hariksk25/Desk-assistant-/case_v6/renders/check_views.png

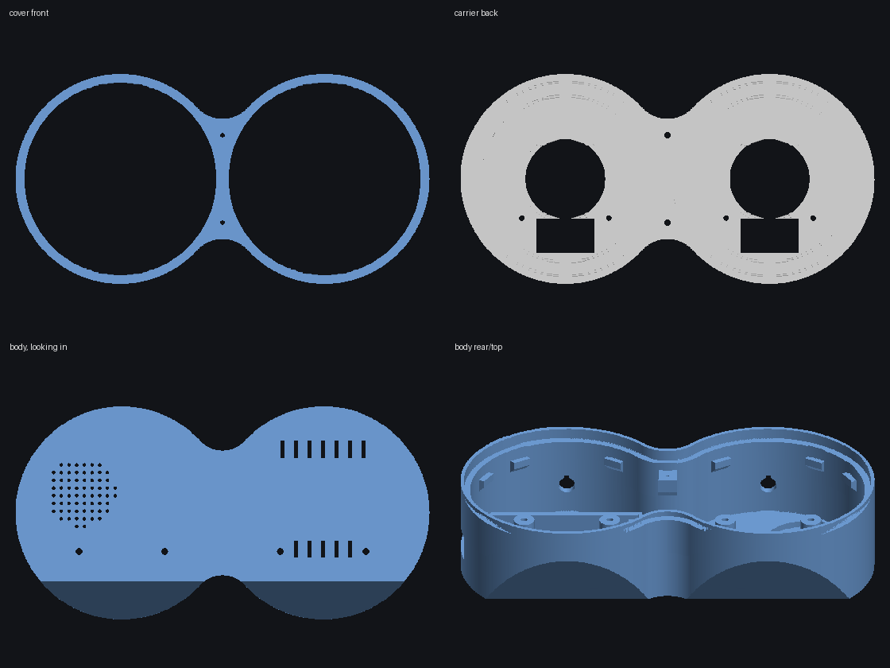
case_v6/renders/check_views.png
