hariksk25/Desk-assistant-/case_v6/renders/clamp_plates.png

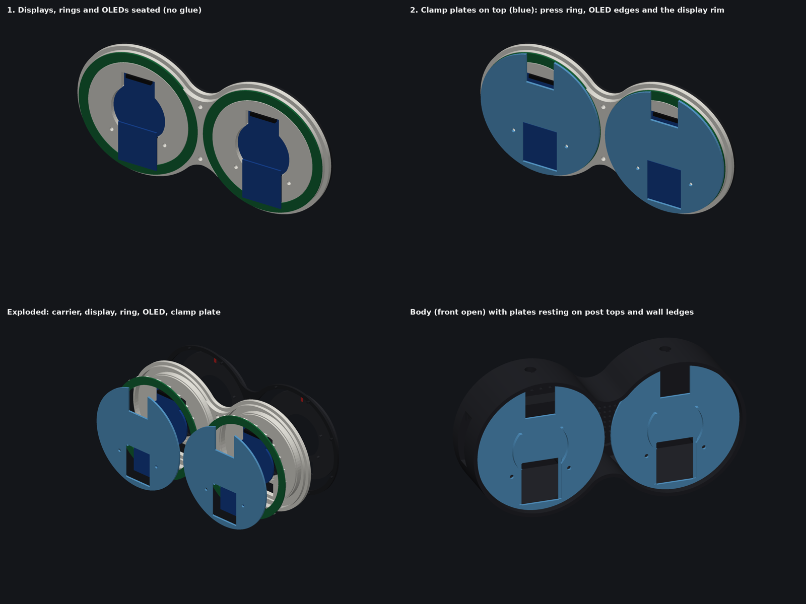
case_v6/renders/clamp_plates.png
