hariksk25/Desk-assistant-/case_v6/renders/final_back_seated.png

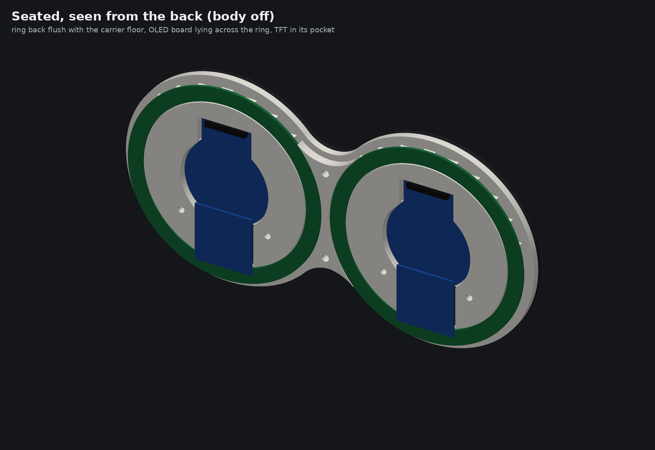
case_v6/renders/final_back_seated.png
