hariksk25/Desk-assistant-/case_v6/renders/final_body.png

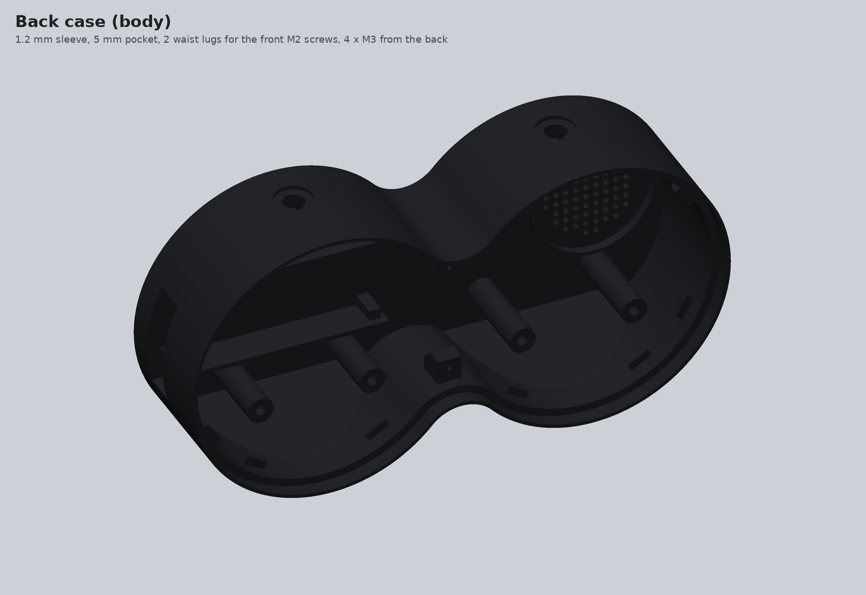
case_v6/renders/final_body.png
