hariksk25/Desk-assistant-/case_v6/renders/final_exploded.png

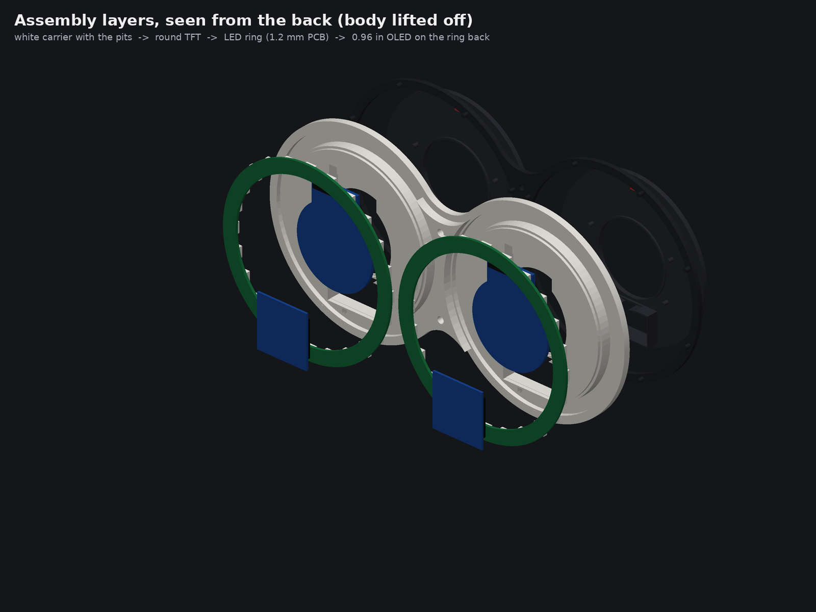
case_v6/renders/final_exploded.png
