hariksk25/Desk-assistant-/case_v6/renders/final_front.png

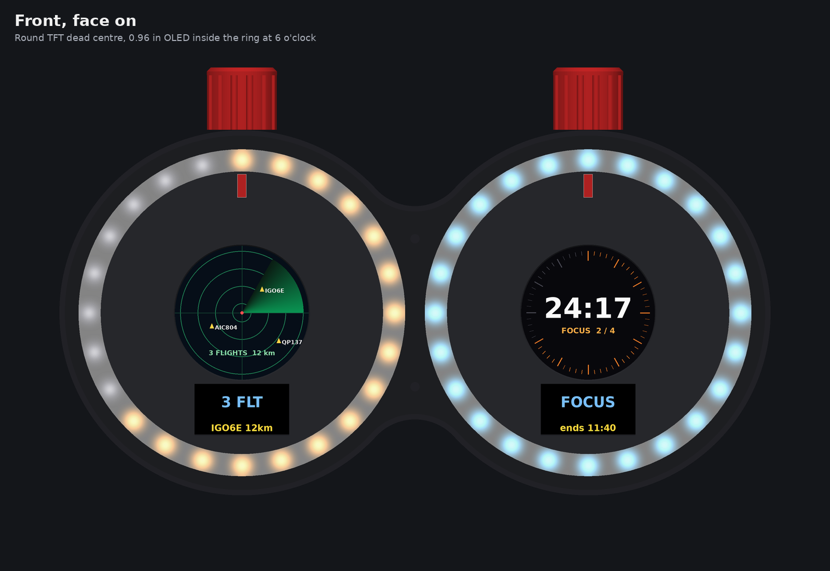
case_v6/renders/final_front.png
