hariksk25/Desk-assistant-/case_v6/renders/final_hero.png

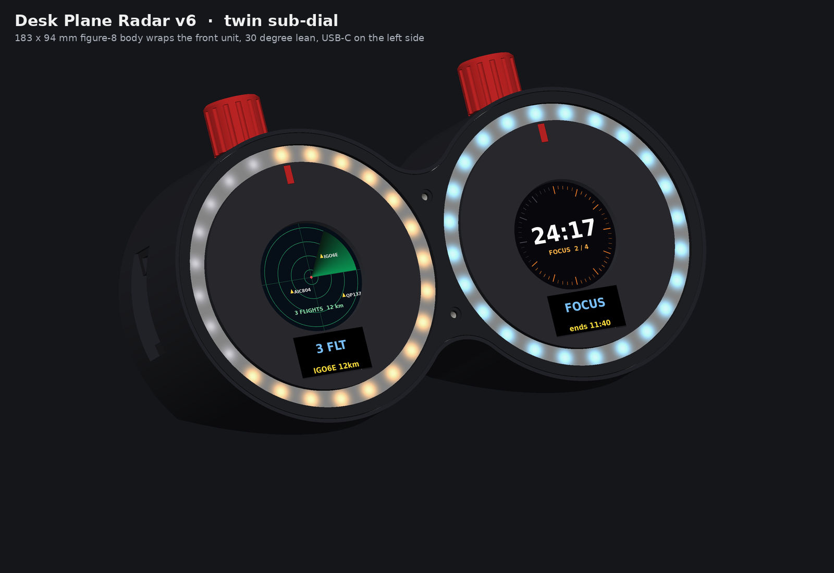
case_v6/renders/final_hero.png
