hariksk25/Desk-assistant-/case_v6/renders/final_rear.png

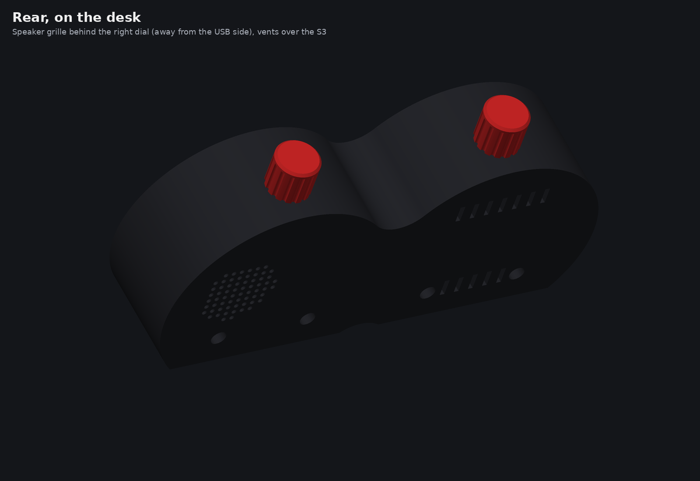
case_v6/renders/final_rear.png
