hariksk25/Desk-assistant-/case_v6/renders/final_side.png

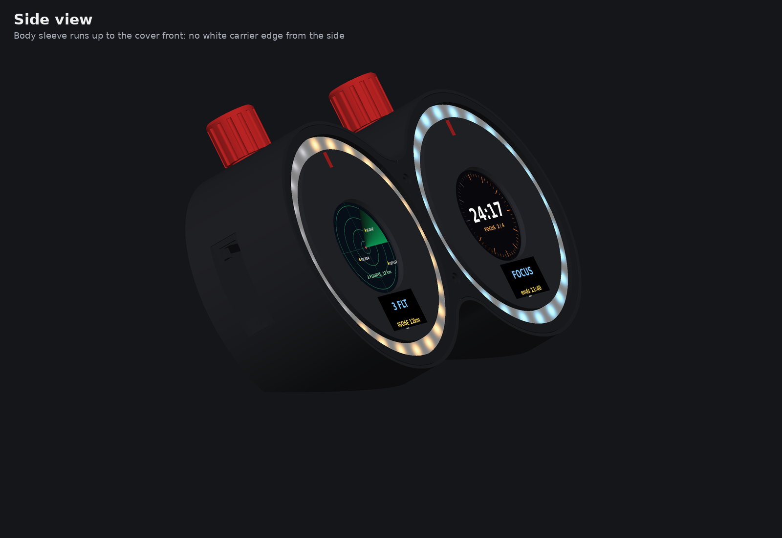
case_v6/renders/final_side.png
