hariksk25/Desk-assistant-/case_v6/renders/front_layouts_A_vs_horns.png

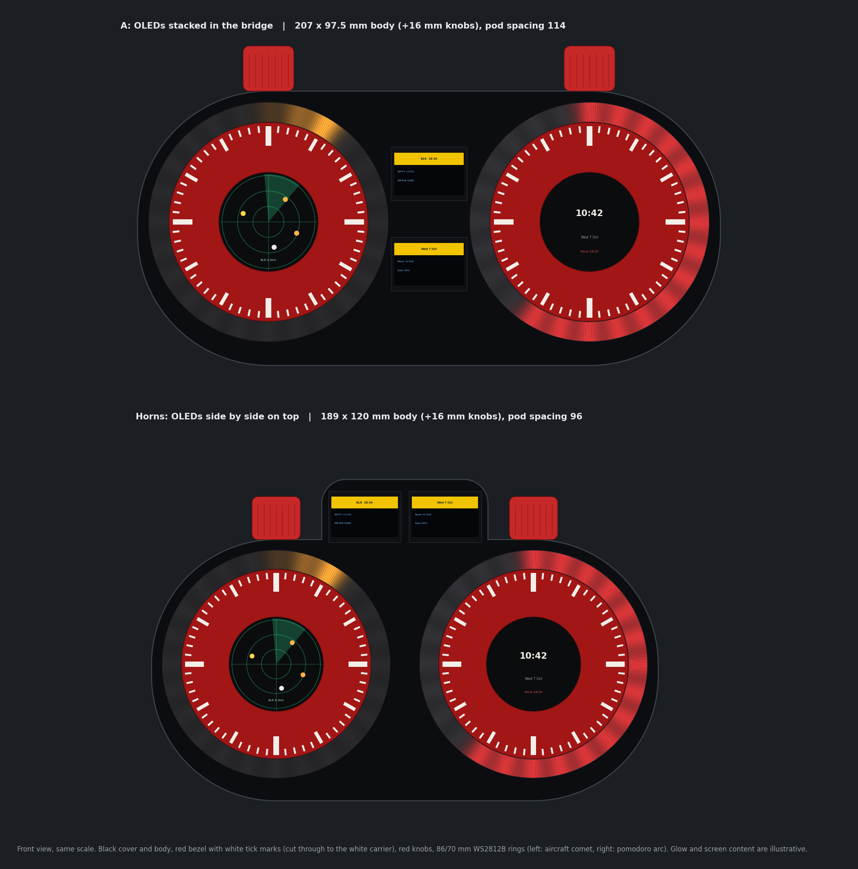
case_v6/renders/front_layouts_A_vs_horns.png
