hariksk25/Desk-assistant-/case_v6/renders/front_screw_section.png

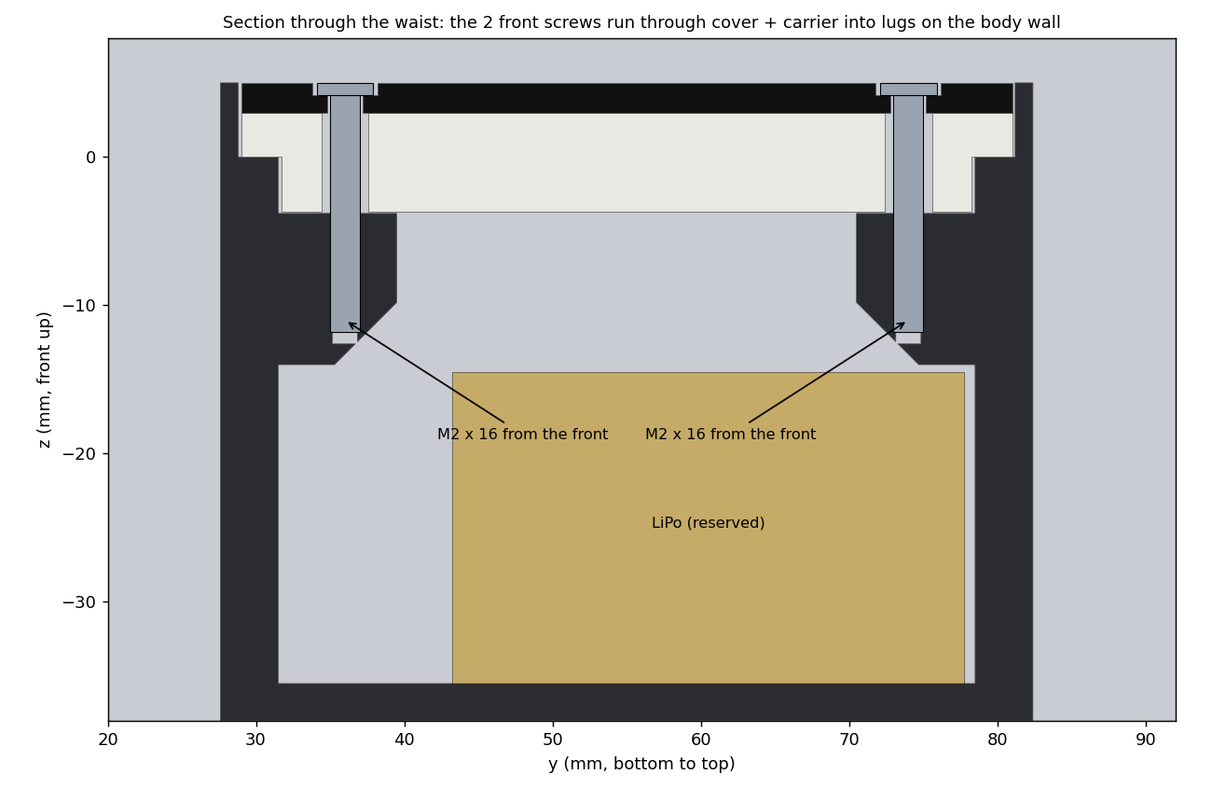
case_v6/renders/front_screw_section.png
