hariksk25/Desk-assistant-/case_v6/renders/internal_layout.png

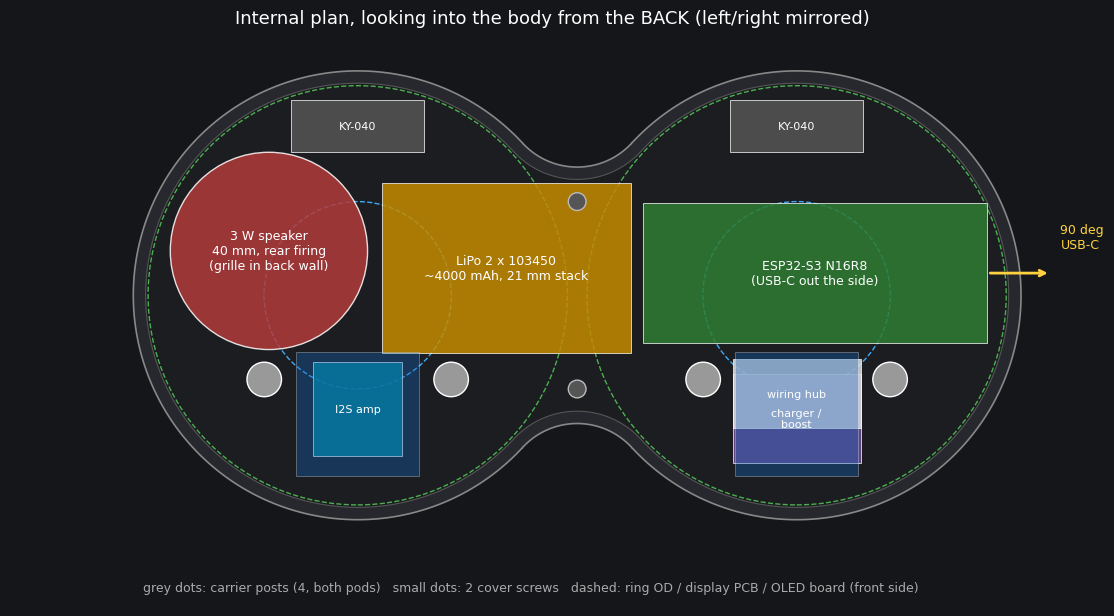
case_v6/renders/internal_layout.png
