hariksk25/Desk-assistant-/case_v6/renders/layout_variations.png

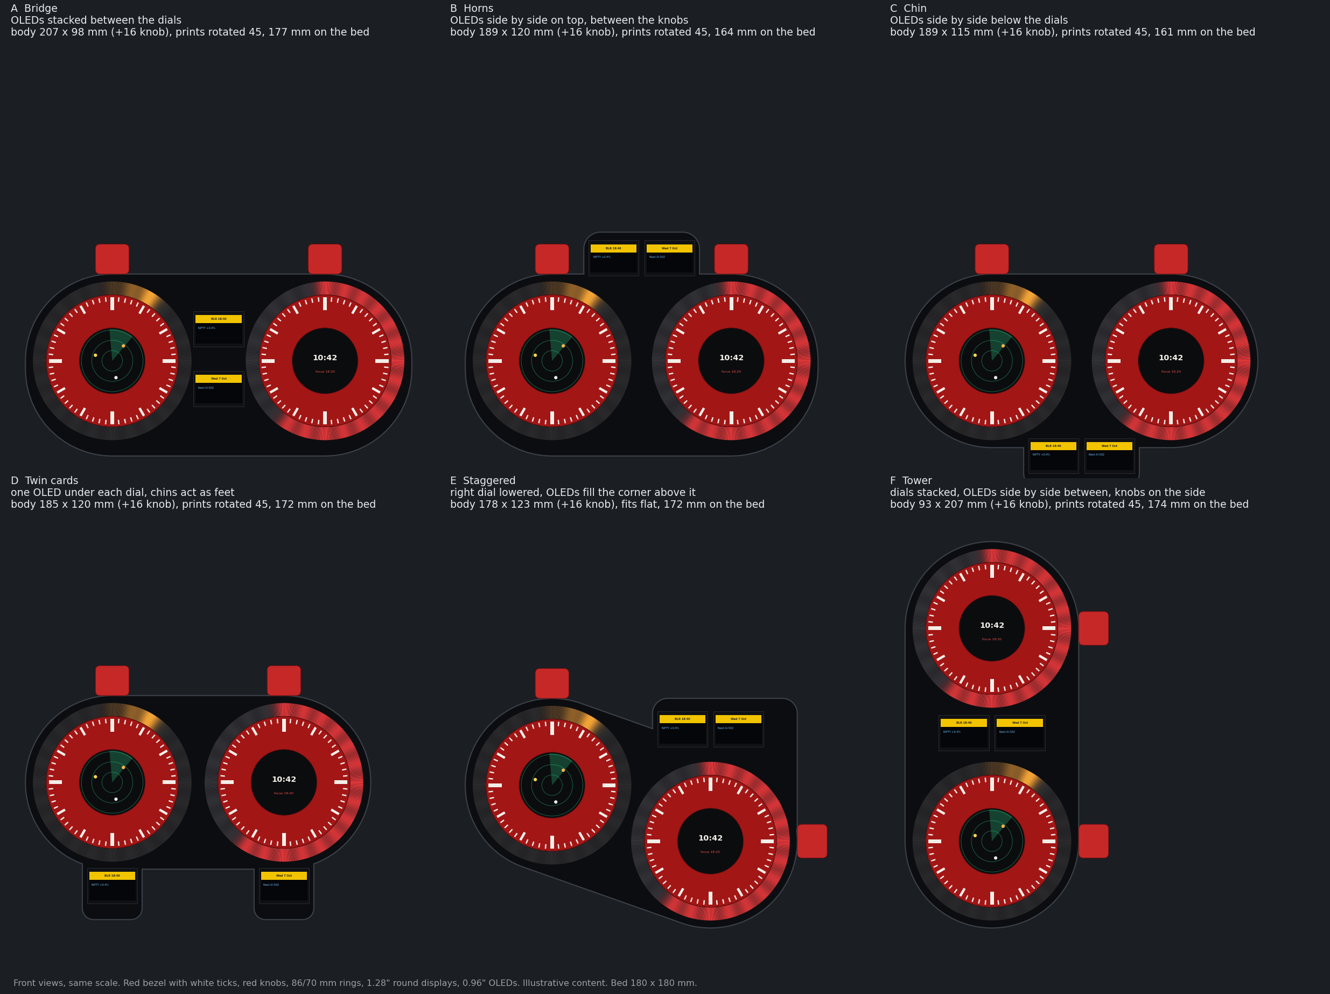
case_v6/renders/layout_variations.png
