hariksk25/Desk-assistant-/case_v6/renders/skirts.png

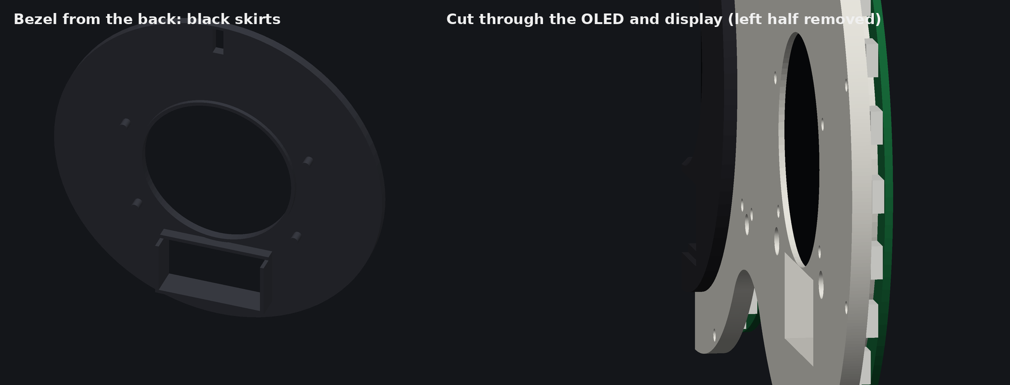
case_v6/renders/skirts.png
