hariksk25/Desk-assistant-/case_v6/renders/subdial_layout.png

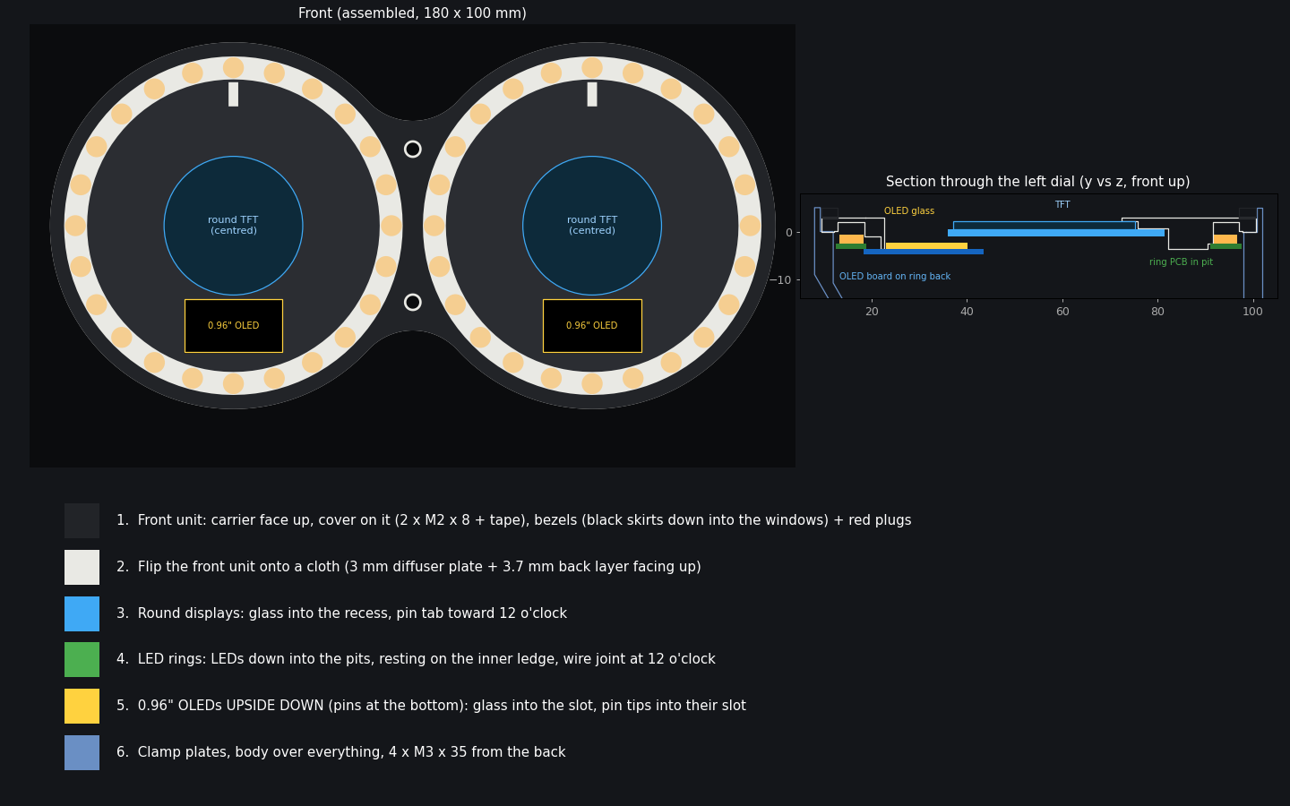
case_v6/renders/subdial_layout.png
