hariksk25/Desk-assistant-/case_v6/renders/v6_horns30_renders.png

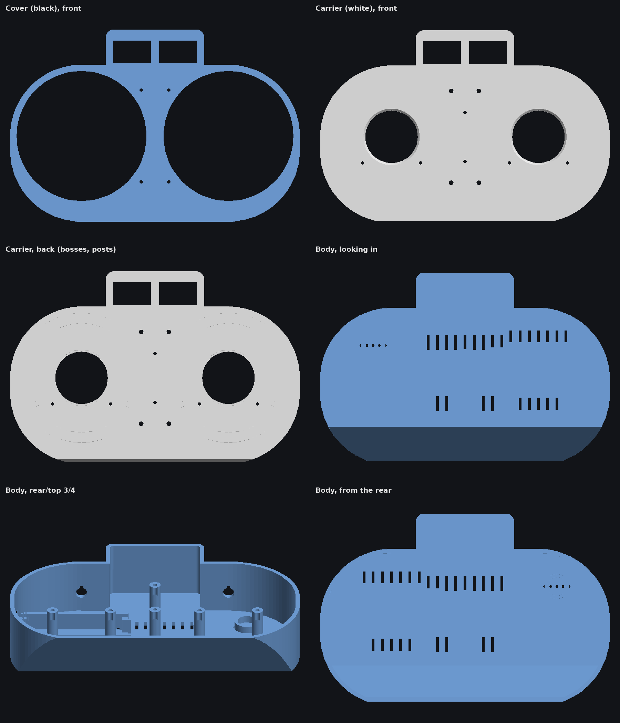
case_v6/renders/v6_horns30_renders.png
