hariksk25/Desk-assistant-/docs/datasheets/OLED_0.96in_yellow_blue_outline.png

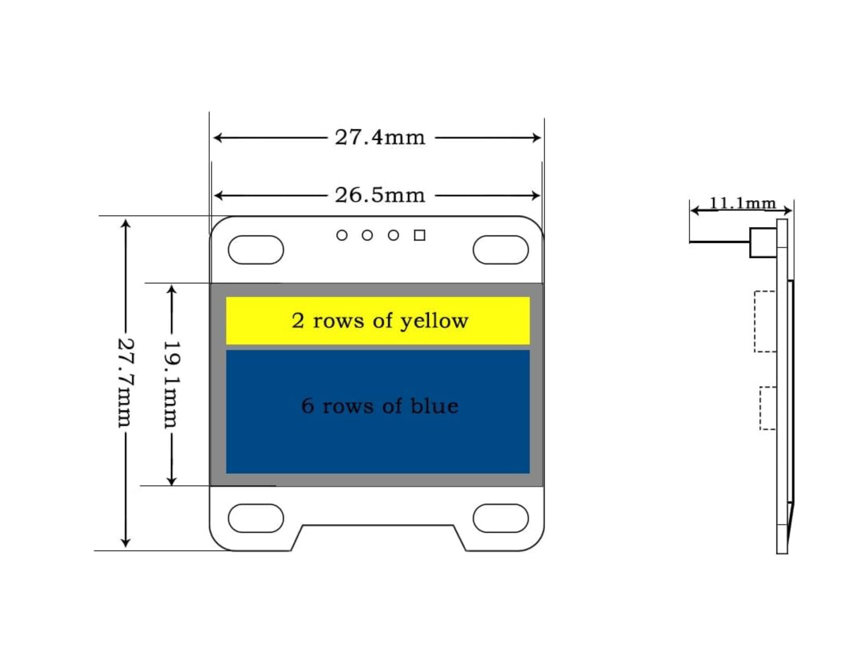
docs/datasheets/OLED_0.96in_yellow_blue_outline.png
