hariksk25/Desk-assistant-/docs/images/pinmap_s3_v6.png

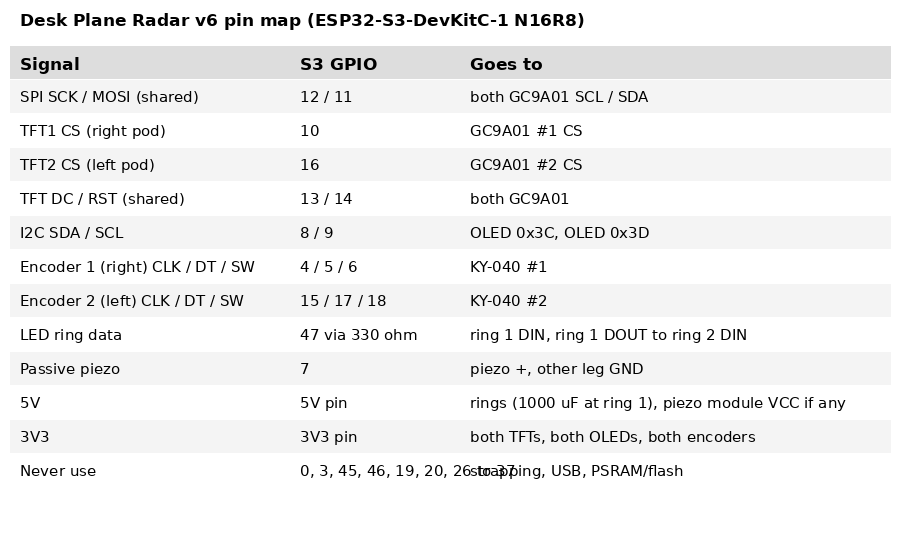
docs/images/pinmap_s3_v6.png
