hariksk25/Desk-assistant-/docs/images/pomodoro_550_real_render.png

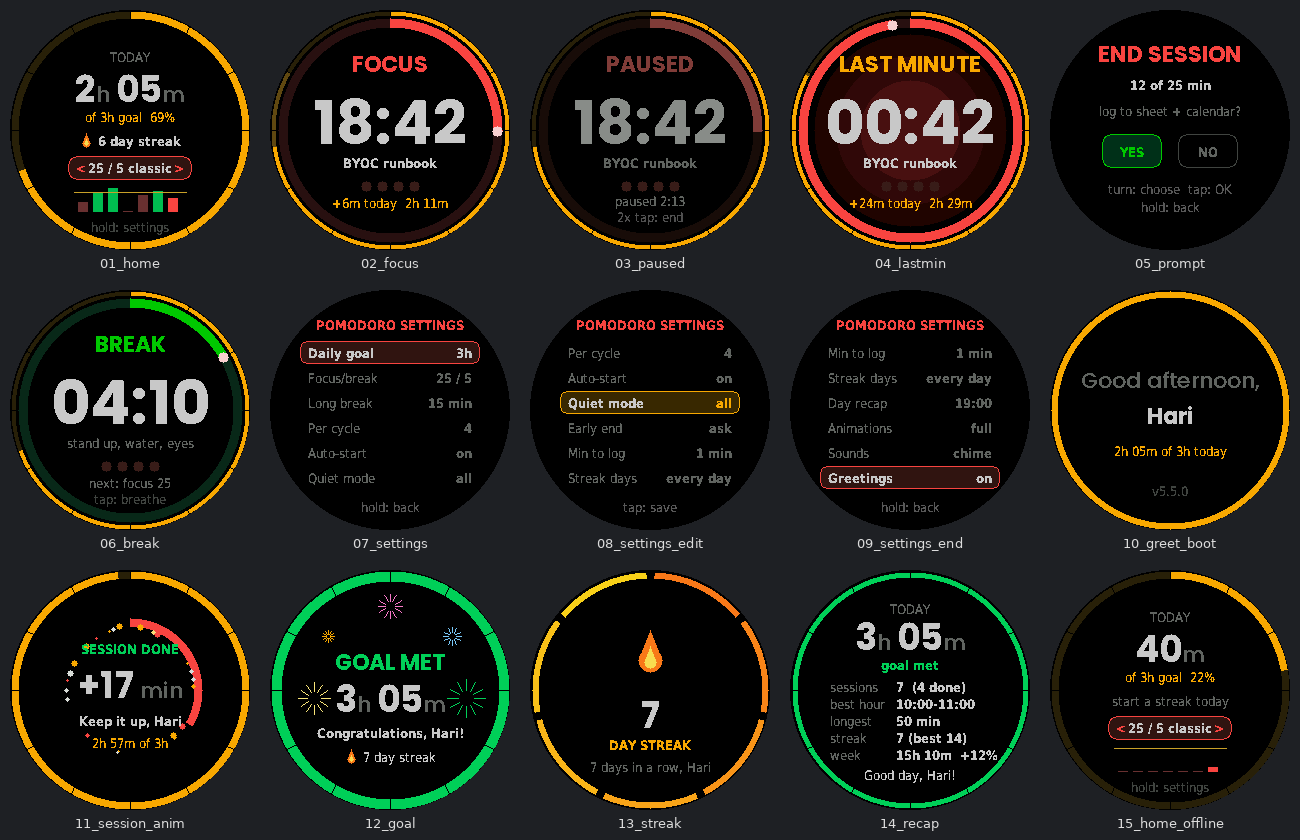
docs/images/pomodoro_550_real_render.png
