hariksk25/Desk-assistant-/docs/images/pomodoro_complete_anim.gif

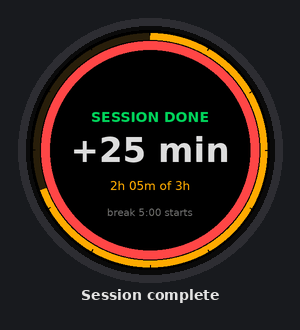
docs/images/pomodoro_complete_anim.gif
