hariksk25/Desk-assistant-/docs/images/pomodoro_mock_screens_pairs.png

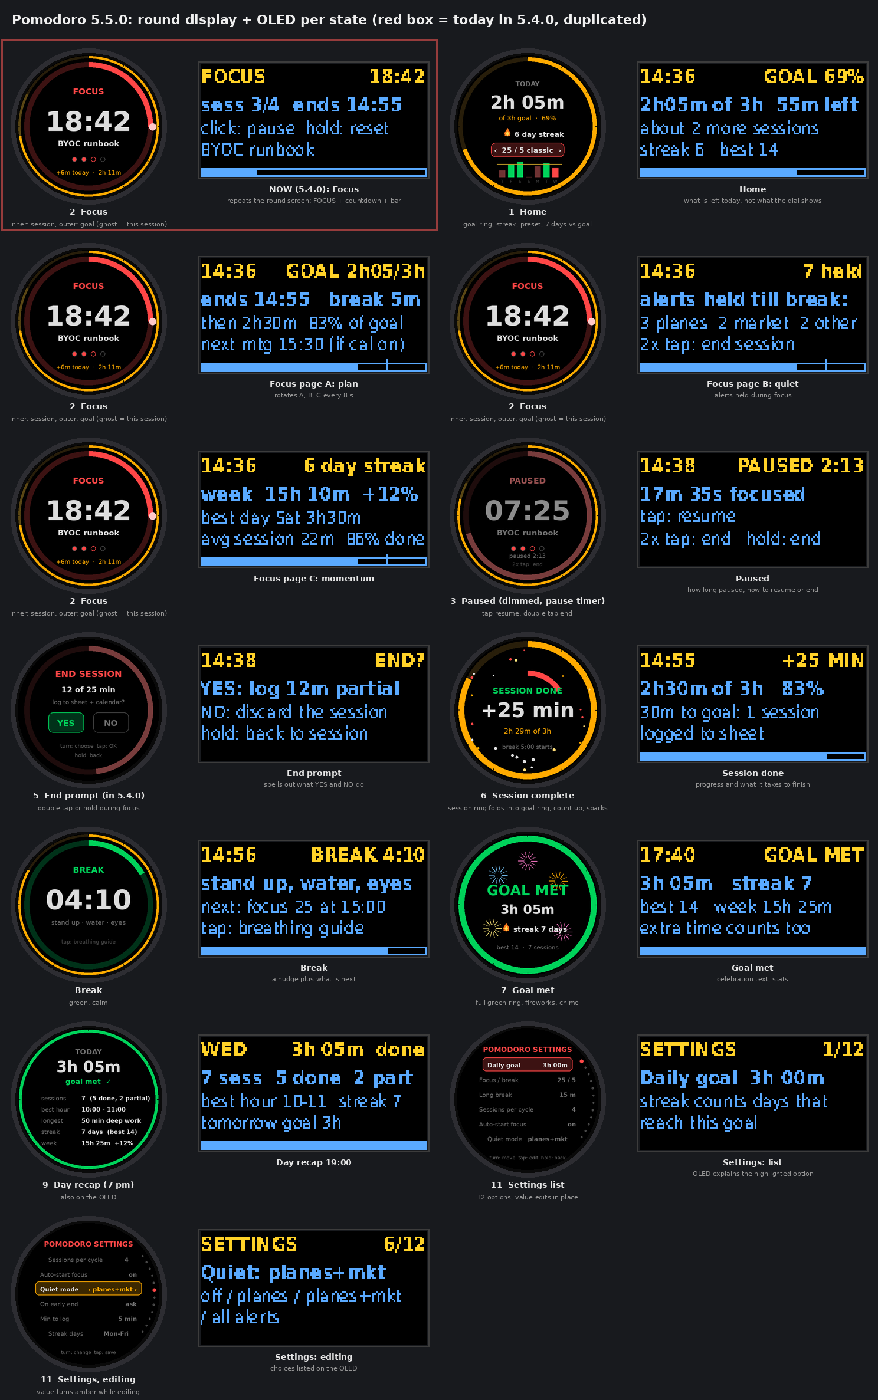
docs/images/pomodoro_mock_screens_pairs.png
