hariksk25/Desk-assistant-/case_v6/stl/v6_clamp_plate.stl

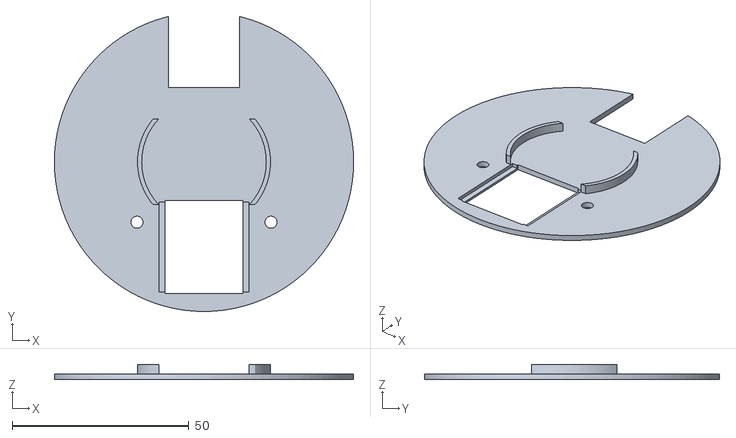
[picture p23: CAD file, 2026-10-13]
case_v6/stl/v6_clamp_plate.stl
84.6 x 83.4 x 4.20
