hariksk25/Desk-assistant-/case_v6/stl/v6_pip_red.stl

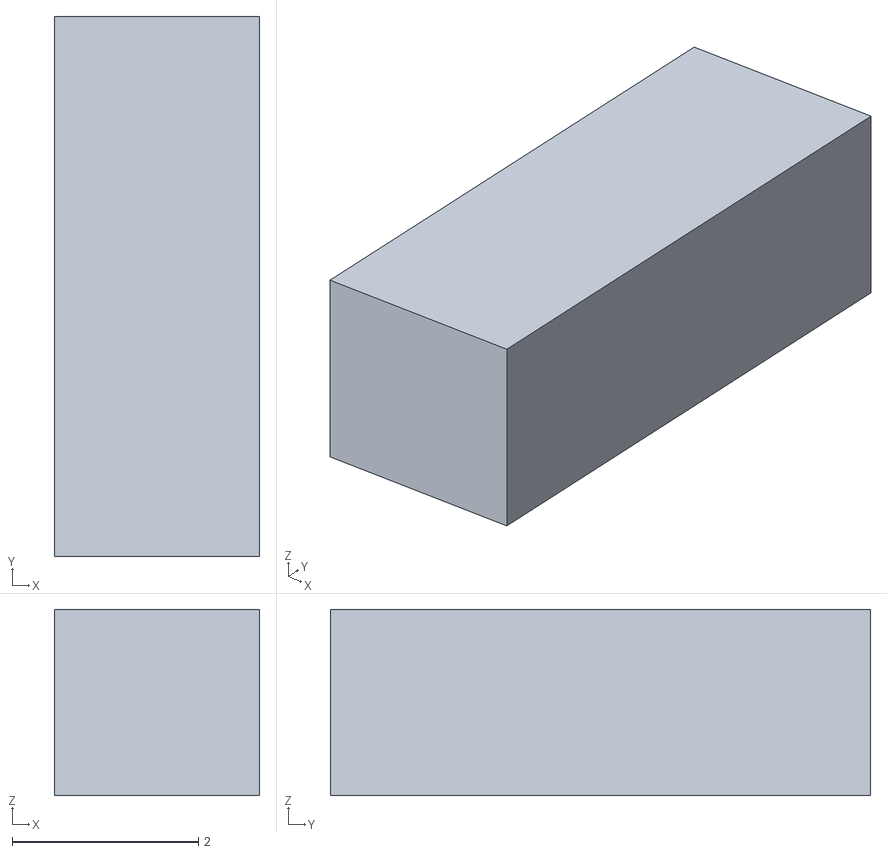
[picture p24: CAD file, 2026-10-13]
case_v6/stl/v6_pip_red.stl
2.20 x 5.80 x 2.00
