hariksk25/Desk-assistant-/case_v6/stl/v6_knob_red.stl

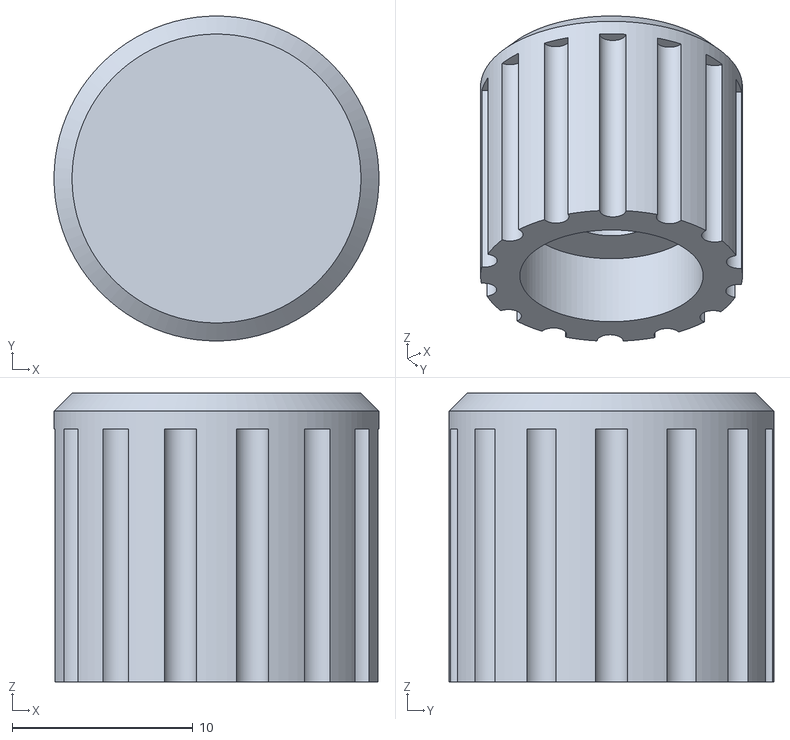
[picture p25: CAD file, 2026-10-13]
case_v6/stl/v6_knob_red.stl
18.0 x 18.0 x 16.0
