hariksk25/Desk-assistant-/case_v6/stl/v6_cover_black.stl

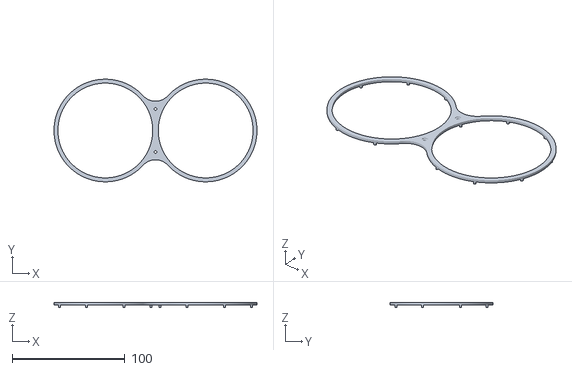
[picture p26: CAD file, 2026-10-13]
case_v6/stl/v6_cover_black.stl
180.0 x 91.0 x 4.40
