hariksk25/Desk-assistant-/case_v6/stl/v6_carrier_white.stl

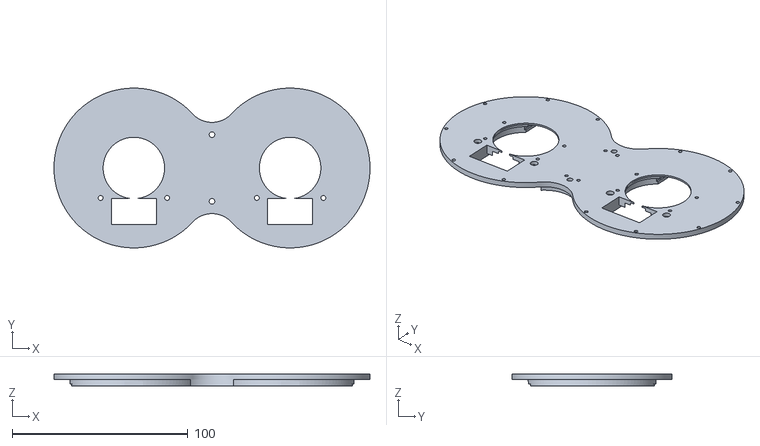
[picture p27: CAD file, 2026-10-13]
case_v6/stl/v6_carrier_white.stl
180.0 x 91.0 x 6.70
