hariksk25/Desk-assistant-/case_v6/stl/v6_bezel_ring_black.stl

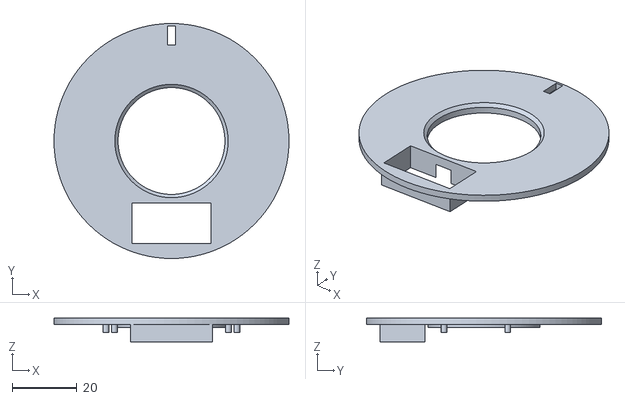
[picture p28: CAD file, 2026-10-13]
case_v6/stl/v6_bezel_ring_black.stl
72.6 x 72.6 x 7.33
