hariksk25/Desk-assistant-/case_v6/stl/v6_body.stl

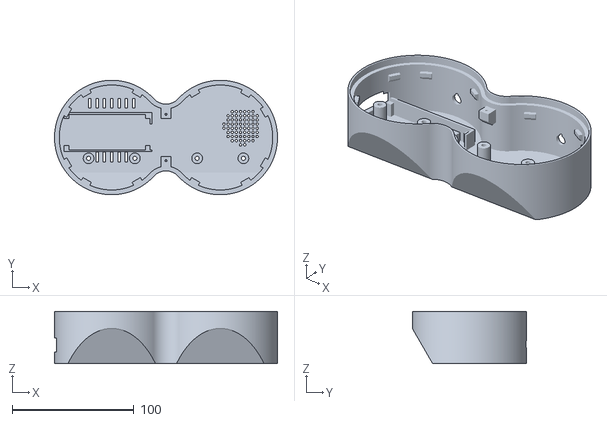
[picture p29: CAD file, 2026-10-13]
case_v6/stl/v6_body.stl
182.8 x 93.8 x 43.0
