hariksk25/Desk-assistant-/docs/BUILD_GUIDE.md

# Desk Plane Radar (ESP32, 2 screens) - Build Guide

Source model: [MakerWorld 3090203 by Noah Thio](https://makerworld.com/en/models/3090203-desk-plane-radar-esp32-with-2-screens)
Firmware in this folder: `desk_plane_radar.ino` (unified metric/imperial, creator's API keys removed, imperial scaling bug fixed, poll interval made safe for the free OpenSky tier).

## 1. What you are building

| Part of the device | What it does |
|---|---|
| Round 1.28" GC9A01 TFT | Radar view: 3 range rings, N/E/S/W, home marker, one blip per aircraft, selected aircraft in red |
| 0.96" SSD1306 OLED | Selected aircraft: callsign, altitude (ft), speed (kt), heading, distance, aircraft type |
| KY-040 rotary encoder | Rotate = zoom (10/25/50/100/200 km) or step through aircraft. Click = toggle ZOOM / SELECT mode |
| ESP32 DevKit | WiFi to OpenSky every 30 s, hexdb.io lookup for aircraft type, drives both screens |

## 2. Bill of materials (final, ordered 30 Sep 2026)

| # | Item | Spec that matters | Qty | Source | Rs |
|---|---|---|---|---|---|
| 1 | ESP32 WROOM-32 DevKit, 30-pin, USB-C, CH340 (oceanlabz) | Classic ESP32, not C3/S3. Sketch uses VSPI and GPIO 25/26/27. USB-C plug is ~1 mm larger than micro USB; file the case slot if tight | 1 | Amazon | 582 |
| 2 | 1.28" round TFT GC9A01 240x240 SPI IPS, 7-pin | Round PCB with bottom tab, header RST CS DC SDA SCL GND VCC (same order as the wiring diagram). Not the octagonal Waveshare-style board | 1 | Amazon | 502 |
| 3 | 0.96" OLED SSD1306 128x64 I2C (Robocraze) | 4-pin GND VCC SCL SDA, address 0x3C (sometimes 0x3D). Not the 1.3" SH1106 | 1 | Amazon | 329 |
| 4 | KY-040 rotary encoder (Electronic Spices) | Pins CLK DT SW + GND match the diagram. A SmartElex clone works too: SIA=CLK, SIB=DT | 1 | Amazon | 101 |
| 5 | M2 x 3 mm brass heat-set inserts | 12 needed (4 case corners + ~8 lid module holes), 3 spare. Creator's holes are for 3.5 mm OD; 3.2 mm OD also works | 15 | OnlyScrews | 27 |
| 6 | M2 x 12 mm hex socket head screws | Lid to case corners | 4 | OnlyScrews | 31 |
| 7 | M2 x 6 mm Phillips wafer ("laptop") head screws | Modules to lid underside. Flat underside, don't use countersunk (CSK) | 10 | OnlyScrews | 42 |
| 8 | Dupont jumper wires F-F, 10 to 20 cm | ~20 | 1 set | Amazon / have | ~60 |
| 9 | PLA | ~63 g case + ~5 g ESP32 tray | | have | |
| | Total parts | | | | ~1,675 + shipping |

Tools: soldering iron (heat-set inserts), PH0 Phillips, 1.5 mm Allen key, USB-C cable, 5V USB supply.

ESP32 mount: the case has no board mount, only a shelf and the USB wall slot. Print `esp32_devkit_v1_tray.stl` (generated by `make_tray.py`, 55.3 x 32.3 x 13 mm, pocket for a 51.5 x 28.5 mm board) and tape or glue it to the shelf, USB end toward the slot. Measure the board and shelf first; edit BOARD_L / BOARD_W in the script if they differ.

## 3. Wiring

This is the creator's diagram and README, verified against the pin defines in the sketch. All VCC to 3V3, all GND to GND.

| Component | Pin on module | ESP32 GPIO | Bus |
|---|---|---|---|
| 0.96" OLED | SDA | 21 | I2C (default Wire) |
| 0.96" OLED | SCL | 22 | I2C |
| 0.96" OLED | VCC | 3V3 | |
| 0.96" OLED | GND | GND | |
| Round GC9A01 | SCL (SPI clock) | 18 | VSPI SCK |
| Round GC9A01 | SDA (MOSI) | 23 | VSPI MOSI |
| Round GC9A01 | CS | 5 | |
| Round GC9A01 | DC | 2 | |
| Round GC9A01 | RST | 4 | |
| Round GC9A01 | VCC | 3V3 | |
| Round GC9A01 | GND | GND | |
| KY-040 encoder | CLK | 25 | interrupt |
| KY-040 encoder | DT | 26 | interrupt |
| KY-040 encoder | SW | 27 | interrupt, FALLING |
| KY-040 encoder | + | 3V3 | |
| KY-040 encoder | GND | GND | |

Notes:
- GPIO 2, 4, 5 are ESP32 strapping pins but are fine as outputs here. If the board ever refuses to enter flash mode, unplug the round display's CS/DC wires while uploading, then reconnect.
- The GC9A01 module has no MISO and no backlight pin on most 7-pin boards; nothing to connect there.
- Wire everything on the bench and test before you heat-set inserts or close the case.

## 4. Firmware setup (Arduino IDE 2.x)

| Step | Action |
|---|---|
| 1 | File > Preferences > Additional boards manager URLs: add `https://espressif.github.io/arduino-esp32/package_esp32_index.json` |
| 2 | Tools > Board > Boards Manager: install **esp32 by Espressif Systems** (3.x is fine) |
| 3 | Library Manager, install: **Adafruit GFX Library**, **Adafruit SSD1306**, **GFX Library for Arduino** (by moononournation), **ArduinoJson** (v7 is fine, v6 also works) |
| 4 | Create an OpenSky account at opensky-network.org. Log in > Account > create an **API client**. Copy the client ID and secret. Free tier = 4,000 credits/day, each poll at these ranges costs 1 credit |
| 5 | Open `desk_plane_radar.ino`. Fill in the USER CONFIG block: WiFi SSID/password, HOME_LAT / HOME_LON (right-click your house in Google Maps, copy the two numbers), OpenSky client ID/secret. Leave `UNITS_IMPERIAL 0` for km |
| 6 | Tools > Board: **ESP32 Dev Module**. Port: the USB serial port that appears when you plug the board in (macOS: `/dev/cu.usbserial-*` or `/dev/cu.SLAB_USBtoUART`; install the CP210x or CH340 driver if nothing shows up) |
| 7 | Upload. If it hangs at "Connecting...", hold the BOOT button on the DevKit until upload starts |
| 8 | Tools > Serial Monitor at 115200. You should see `WiFi connected`, `OpenSky token refreshed OK`, `States fetch HTTP code: 200`, `Planes in range: N` |

Default behaviour after boot: 100 km range, ZOOM mode. Click the encoder to switch to SELECT, rotate to walk through aircraft nearest-first. Selected plane is red on the radar and its details are on the OLED.

## 5. Printing

Creator's settings, from the MakerWorld profile:

| Setting | Value |
|---|---|
| Material | PLA |
| Layer height | 0.2 mm |
| Walls | 2 |
| Infill | 15% |
| Supports | Check the 3MF / profile; the round screen bezel usually needs none |
| Print time | ~1.8 h |
| Filament | ~63 g |

Download the 3MF and the Assembly Guide PNG from the model page (login needed). Print the enclosure first so the inserts can go in while you wait for parts.

## 6. Assembly order

| Step | What | Tip |
|---|---|---|
| 1 | Heat-set the M2 inserts into the printed body | Iron at ~200 to 220 C for PLA, press straight down slowly, let cool before loading |
| 2 | Bench-test the full circuit on the desk with the sketch already flashed | Fix wiring now, not after closing the case |
| 3 | Mount the round TFT in the bezel, OLED in the square window | Route ribbon/Dupont leads before screwing anything down |
| 4 | Mount the encoder, fit the knob | Trim the encoder's pin header if it fouls the case |
| 5 | Seat the ESP32, USB port facing the cutout | |
| 6 | Close with M2 bolts | |

## 7. Troubleshooting

| Symptom | Likely cause | Fix |
|---|---|---|
| OLED blank, serial says `SSD1306 init failed` | Module is at 0x3D not 0x3C, or SDA/SCL swapped | Change `0x3C` to `0x3D` in `setup()`, or swap the wires |
| Round screen white or garbage | SCL/SDA (18/23) swapped, or CS/DC/RST wrong | Recheck the SPI table above |
| Round screen colours inverted | IPS flag | Change the `true` in `new Arduino_GC9A01(bus, TFT_RST, 0, true)` to `false` |
| Radar rotated | Rotation param | Change the `0` in the same constructor to 1, 2 or 3 |
| `Token fetch failed, HTTP code: 401` | Wrong OpenSky client ID/secret | Recreate the API client, paste exactly |
| `States fetch HTTP code: 429` | Daily credits exhausted | Keep `POLL_INTERVAL_MS` at 30000 or higher; credits reset daily |
| `States fetch HTTP code: -1` | TLS/heap or WiFi drop | Power from a proper 5V 1A supply, not a laptop hub; check `Free heap` in serial stays above ~60 kB |
| Few or no planes over Bengaluru while FlightRadar24 shows plenty | OpenSky depends on volunteer receivers and coverage over India is thinner than the UK | Try 200 km range first. If it stays sparse, the fetch can be ported to adsb.lol or airplanes.live (free, no key, better Indian coverage). Ask and I'll do that variant |
| Encoder skips or double-steps | Cheap encoder bounce | The quadrature table already filters; if still bad, add 100 nF caps from CLK and DT to GND |
| Upload fails "Failed to connect" | Strapping pins pulled by displays | Hold BOOT during upload, or disconnect the round display while flashing |

## 8. Verification status

| Check | Result |
|---|---|
| Pin map: wiring diagram vs README vs sketch defines | All three agree |
| Creator's OpenSky credentials removed from sketch | Yes, placeholders in USER CONFIG |
| Imperial radar scaling bug | Fixed: all distance math in km, units only affect labels |
| Free tier credit budget at 30 s polling | 2,880 requests/day < 4,000 credits/day |
| Compile | Syntax-checked against stub Arduino headers in both unit modes, clean with -Wall. Full ESP32 toolchain compile not possible in this sandbox (download hosts blocked). First real compile happens on your Mac; report any error and I'll fix it |

## 9. Firmware v3 (animated radar + everything)

File: `desk_plane_radar_v3.ino`. Supersedes v1/v2.

| Setting | Value |
|---|---|
| Board | ESP32 Dev Module |
| Partition Scheme | Minimal SPIFFS (1.9MB APP with OTA/190KB SPIFFS) |
| Upload Speed | 115200 (CH340 fails at 921600) |
| Extra library | WiFiManager (tzapu), via Library Manager |

| Control | Action |
|---|---|
| Rotate | Zoom (ZOOM mode) or step through aircraft (SELECT mode) |
| Click < 0.6 s | Toggle ZOOM / SELECT |
| Hold 0.6 to 2 s | Cycle filter ALL / ARR / DEP |
| Hold > 2 s | App menu: Radar, Clock, Weather |

| Feature | Notes |
|---|---|
| Data sources | Default adsb.lol (best coverage over BLR in the Oct 2026 survey). Preferred source set on the web page, automatic fallback through the rest: Local receiver (readsb/dump1090 aircraft.json URL) > adsb.fi > adsb.lol > airplanes.live (feeders only since 2025, 403 otherwise) > OpenSky (key, 30 s polling). Active source shown on the web page and on the OLED when no traffic |
| Web page | http://deskradar.local (or the IP shown on the OLED in Clock/Weather app). Live radar mirror, aircraft table, settings |
| OTA | After first USB flash, the board appears under Tools > Port as a network port |
| Captive portal | If the configured WiFi fails for 20 s, join hotspot DeskRadar-Setup and open 192.168.4.1 |
| Night mode | Auto 22:00 to 07:00 IST, or force on/off from the web page |
| Alerts | New aircraft entering the inner ring: OLED flashes, buzzer on GPIO32 beeps if fitted |
| Colours | Orange = arrival (< 10,000 ft, heading toward home), yellow = departure, green/cyan = en route low/high, red = selected |
| Serial | 115200; WiFi disconnect reason codes are logged (e.g. 2 auth expire, 8 assoc leave, 15 4-way handshake timeout, 201 no AP found, 202 auth fail) |

## 10. ADS-B feeder (planned)

Running your own receiver gives the radar 1 s local updates with no API limits, and restores airplanes.live access (feeders only).

| Item | Approx Rs |
|---|---|
| RTL-SDR Blog V4 or V3 dongle | 3,000 to 3,800 |
| 1090 MHz antenna (kit dipole to start, collinear later) | 800 to 2,000 |
| Host: Raspberry Pi Zero 2 W / Pi 4, or a Mac running Docker 24/7 | 0 to 2,500 |
| SMA extension 3 to 5 m | 300 |

Software: `sdr-enthusiasts/ultrafeeder` Docker container (readsb + feeds to airplanes.live, adsb.lol, adsb.fi, FR24, FlightAware). Point the radar's Local receiver URL at `http://<host>:8080/data/aircraft.json`.

## 11. Firmware v4 (framebuffer rendering, 6 apps)

File: `desk_plane_radar_v4.ino`. Same board, partition scheme and libraries as v3. Flash over USB at 115200 or OTA.

Rendering: 8-bit indexed canvas, painted in two bands of 240x120 (29 KB; `CANVAS_BANDS 2`, set 1 on a board with PSRAM) because a full 57 KB framebuffer left only ~46 KB heap and TLS fetches failed with HTTP -1. SPI at 80 MHz on a DMA bus (`USE_DMA 1`), full redraw every frame, free running. Expect 30 to 40 fps, shown bottom-centre of the radar. Aircraft JSON is parsed one object at a time from the stream (no 32 KB document), so a 200 km range fits too. Serial prints `Heap after canvas` at boot and `heap` on every fetch; keep the idle figure above ~70 KB. If the panel shows noise or stays white: set `TFT_SPI_HZ 40000000`, then `USE_DMA 0`. Text is drawn after the sweep and nothing dims with time. Compass words removed; the dial fills the panel with a white north wedge and 30 degree ticks.

Design rule for the two screens: the round display shows the picture or the one big number; the OLED carries the detail and the control hint for whatever is selected. Yellow band (rows 0 to 15 on two-tone panels) holds the headline, blue area the supporting rows.

| App | Round display | OLED | Controls |
|---|---|---|---|
| Radar | Dial, trails, predicted dashed paths, runway 09/27 funnels, icon+count legend (orange arrival, yellow departure, cyan en route), selected flight card | Callsign, N/total, class, route, type, alt, hdg, speed, distance, bearing, landing ETA. Inverts 4 s on new inner-ring traffic | Rotate zoom / step; click toggle ZOOM-SELECT (during an alert: select that aircraft); hold 0.6-2 s filter |
| Clock | 4 faces: digital with daylight and seconds rings, classic analog, nixie, orbital | Time, date, weather, sunrise/sunset, AQI, humidity, UV, aircraft count | Rotate or click: next face |
| Weather | Animated icon (sun rays, cloud drift, rain, snow, lightning, fog), temp, feels, 3 tiles, 12 h sparkline | Temp, feels, condition, 12 h bar chart with min/max, wind, PM2.5, AQI category, UV | none |
| Pomodoro | Preset list (25/5, 50/10, 90/20, custom); running: progress ring, mm:ss, session dots | Preset details, today's sessions and minutes; running: progress bar, session N/4, end time, controls | Rotate pick (custom: set minutes in 5 min steps); click start / pause / resume / skip break; hold 0.6-2 s stop. Long break 15 min after 4 sessions. Buzzer on transitions |
| Markets | Index value, change pill, intraday area chart with previous-close line, next symbol strip | Selected symbol headline, other 3 symbols, day high/low, OPEN/CLOSED, data age | Rotate next symbol; click refresh now |
| WiFi | 2.4 GHz spectrum, one hump per network (channel, RSSI), selected network highlighted | Connected SSID and RSSI, networks on ch 1/6/11/other, least crowded channel | Rotate pick network; click rescan |
| Menu (hold > 2 s anywhere) | 6 apps, selected boxed | App N/6, one-line description | Rotate, click |

Markets data: Yahoo Finance chart endpoint (`query1.finance.yahoo.com/v8/finance/chart/<symbol>?interval=5m&range=1d`), no key, unofficial. Symbols in `MARKET_SYMBOLS` (`^NSEI`, `^BSESN`, `^NSEBANK`, watchlist `RELIANCE.NS`, edit freely). One symbol fetched per pass: every 15 s per symbol while NSE is open (Mon-Fri 09:15 to 15:30 IST) and the Markets app is showing, every 2.5 min otherwise. If Yahoo starts returning 401/429, the serial log shows `Quote ^NSEI HTTP <code>`.

Persisted in NVS: range, source, filter, night, clock face, Pomodoro preset and custom minutes, market symbol.

Fixes found on hardware (v4.2):

| Symptom | Cause | Fix |
|---|---|---|
| Picture rotated 90 degrees, and garbled into two half-height bands after the memory fix | The 6th `Arduino_Canvas_Indexed` constructor argument is the canvas rotation, not the palette mask level; it was 1 | Argument is 0 now. `TFT_ROTATION` (0..3) in the config turns the whole picture if it is not upright in your case |
| `HTTP -1` on every source with heap ~46 KB | TLS needs ~45 KB free; the 57 KB framebuffer and a 32 to 48 KB JSON document did not leave it | Two 240x120 bands, aircraft parsed one object at a time from the stream. Idle heap ~92 KB, ~46 KB during a TLS fetch |
| `adsb.lol HTTP 403` on every cycle while adsb.fi delivered | adsb.lol rate limit (needs >= 15 s between calls) was hit every 10 s because the poll interval followed the active source | Per-source minimum intervals (`SRC_MIN_MS`) and a 1, 2, 4 ... 16 min backoff on 403/429, logged as `adsb.lol rate limited`. A range or source change still fetches at once |
| Rings and arcs start at 9 o'clock | Arduino_GFX measures arc angles from 3 o'clock, the dial math from 12 | `ringArc()` converts; if an arc still starts in the wrong place, change the -90 in `ringArc` |

The 24 h daylight ring on the clock has noon at the top (sun marker climbs left to right), not midnight as in the mockup.

## 12. Firmware v5 (fonts, 14 apps, alerts)

File: `desk_plane_radar_v5.ino` (4,260 lines, single file). Same board, partition scheme and libraries as v3/v4 (no new library). Flash over USB at 115200, OTA from the IDE, or from the browser at http://deskradar.local/update (Sketch > Export Compiled Binary, upload the .bin).

Fonts: Poppins Bold 60/36 px for numbers, Poppins Medium/Bold 22 px, DejaVu Sans Condensed 13 px, all embedded as 1-bit GFX fonts (8 KB) and drawn by the firmware's own blitter, so they work with the two-band canvas. `gen_fonts.py` regenerates them.

Menu (hold 2 s, scrolls): RADAR, ARRIVALS, APPROACH, CLOCK, WEATHER, POMODORO, MARKETS, NETWORK, STATS, NEWS, CRICKET (only with a key), SYSTEM, BRIGHTNESS, LOCATION.

| App | Round display | OLED | Knob |
|---|---|---|---|
| RADAR | v4 dial plus METAR wind and runway in use, destination tags on departures, type-based icons (prop, jet, heavy, helicopter), holding rings, follow mode, auto range (past 200 km) | callsign, time, N/total, route + type + reg, alt/hdg, speed/distance/where-to-look, landing line | rotate zoom or select, click toggle, hold = filter (zoom) or follow (select) |
| ARRIVALS | board sorted by ETA with origin and clock time, departures page with destination and FL; any airport from `AIRPORTS` | next 4 rows | rotate highlight, click arr/dep, hold next airport |
| APPROACH | distance vs altitude with the 3 degree glideslope, on-slope / high / low readout | selected aircraft detail, wind, QNH | rotate highlight, click selects it on the radar |
| CLOCK | Bold (daylight + rain ring), Analog, Dashboard (weather, AQI, next arrival, NIFTY, countdown), World (2 zones) | time, date, weather, sun, AQI, aircraft, alarm, news ticker | rotate/click face, hold alarm on/off |
| WEATHER | now (animated icon, tiles, 12 h line), 3-day forecast, 24 h history from own samples | time, temp, 12 h bars, rain-soon or wind/AQI/UV, ticker | rotate/click pages |
| POMODORO | presets + custom, ring timer, 7-day bars | timer, progress, session, nudges | as v4 |
| MARKETS | 7 symbols with intraday chart, gold in INR per 10 g, mutual funds page (mfapi.in), portfolio day P&L | time, symbol, other symbols, NSE state, ticker | rotate symbol/page, click refresh |
| NETWORK | gateway (ICMP ping to the Deco), internet (1.1.1.1), DNS; 10 min log graph; node, outage log | gw/wan/dns ms, node, outages | none |
| STATS | aircraft today by hour and class, records; spotter log of airlines and types | totals, records | rotate/click pages |
| NEWS | headlines from `NEWS_FEEDS` | current headline | rotate scroll, click skip 3 |
| SYSTEM | heap, fps, uptime, RSSI, fetch counts; sources page with backoff | summary | rotate pages |
| BRIGHTNESS | round (palette scaling, the module has no backlight pin) and OLED contrast | values | rotate adjust, click switch, hold back |
| LOCATION | choose the radar home from `AIRPORTS` | selection | click sets |

Alerts: OLED banner (no inversion any more) + toast on the round display + buzzer melody. Inner-ring traffic, emergency squawk, heavy/military, flight watch (`FLIGHT_WATCH`), overhead pass with where to look, go-around, rain in the next 2 h, golden hour and sunset, market threshold (`MARKET_ALERT_PCT`), earthquake M5+ within 1,500 km, stand/water nudge, alarm. A click during an aircraft alert selects that aircraft.

Config knobs: `AIRPORTS` (home + board), `FLIGHT_WATCH`, `MARKET_SYMBOLS`, `PORTFOLIO`, `MF_SCHEMES`, `NEWS_FEEDS`, `CRICAPI_KEY`, `COUNTDOWNS`, `ZONES`, `LOCAL_TZ`. Web settings: home and board airport, lat/lon, source, range (incl. auto), filter, night, clock face, both brightnesses, sleep hours, alarm (time, on, days), nudge minutes. Also /screen.bmp (pixel-exact screenshot) and /log.

Data sources added: aviationweather.gov METAR (no key), adsb.lol routeset (batch routes), Open-Meteo minutely/daily, mfapi.in, USGS, RSS feeds, CricAPI (key). All unofficial except USGS/Open-Meteo; a 4xx shows up in /log.

RAM note: idle heap target >= 65 KB (serial prints `Heap after setup`). If TLS fetches start failing with HTTP -1, reduce `MAX_PLANES`, `MAX_BOARD` or `MAX_NEWS`.

### v5.1 additions (flash only, RAM unchanged)

| Addition | Where |
|---|---|
| Aircraft silhouettes from a type table (`TYPES`): wingspan to scale, wing sweep, 1/2/3/4 engines as dots, propellers as circles, helicopters as a rotor cross. Longest prefix wins (C17 vs C172) | Radar |
| Airline colour chips (two-letter code on the airline's colour, `AIRLINES` table) | Radar card, Arrivals rows |
| Clock faces 5 to 9: 24 Hour (noon at top, daylight + rain ring, one hand), Minimal, Flip, Seconds, Night Sky (moon phase, days to full/new, sun times, day length) | Clock, web select |
| `AIRPORTS` grown to 42 (40 Indian + DXB, SIN) with main runway heading and elevation | LOCATION, Arrivals board |
| Night weather icons (moon, moon + cloud), wind streaks on clear windy days | Weather |
| FINAL page: top-down view of the final approach, centreline, 5 km marks, green when within 500 m of the centreline, heading ticks relative to the runway | Approach, hold the knob to switch |
| Recent alerts page (last 10 with time) | Stats page 3, web page |
| Daily summary toast at `SUMMARY_HOUR` (21:00): aircraft, focus minutes, AQI max, outages; yesterday's count on Stats | automatic |
| Watch list and countdowns editable in the browser, stored in NVS; empty = sketch defaults | Web settings |
| /oled.bmp: 1-bit screenshot of the OLED | Web |

Not done: Kannada/Hindi numerals (no Indic font available in the build environment; send a TTF and gen_fonts.py can make the glyphs).

## 13. Firmware v5.2 (scratch arena, 16 apps, 25 additions)

File: `desk_plane_radar_v5.ino` (5,230 lines). Same board, partition scheme and libraries as v5. Flash over USB at 115200, OTA, or from http://deskradar.local/update. Settings from v5/v5.1 are kept (NVS keys unchanged, new ones added).

### How RAM is laid out now

| Pool | What lives there | Size |
|---|---|---|
| Resident, always on | planes, trails, routes, weather (+pollutants, rain), METAR, TAF, SIGMET, destination weather, 7 quotes (price/change/high/low only), news headlines, quakes, alert log, stats, Pomodoro, outages, F1 info, heap/fps history, roaming log | fixed, same as v5 or smaller |
| Scratch arena | one 3.4 KB buffer owned by the app on screen: replay tracks (radar group), remote arrivals board, market chart + heat map + MF NAVs, network latency history, cricket | 3,400 B |
| Two 240x120 canvas bands | the round display framebuffer | 29 KB |

The arena is handed over by `arenaAcquire()` when you enter an app (cleared under the data mutex, the fetch task writes into it only while that group owns it). What this means in use: the market chart, heat map, NAVs, 10 min network graph and cricket scores start empty when you open those apps and fill within one fetch cycle; the replay history is kept while you stay in RADAR / ARRIVALS (home) / APPROACH / REPLAY and starts again after a visit to MARKETS, NETWORK, CRICKET or a remote arrivals board. Everything that raises an alert (traffic, squawk, watch list, go-around, SIGMET, rain, markets, quakes, nudges, timer, alarm) runs on resident state, so a radar alert still appears while the Pomodoro is running. Idle heap should come out ~6 KB above v5.1; `Heap after setup` in the serial log tells.

### Additions

| # | Addition | App / where | Knob or setting |
|---|---|---|---|
| 1 | REPLAY app: last 48 minutes of tracks from the arena, one sample per aircraft per minute, playback with a time bar and the clock time of the frame | REPLAY | rotate scrub, click play/pause, hold back to now |
| 2 | F1 app: next race countdown (days or h:mm to lights out), local start time, last podium (jolpi.ca Ergast mirror, 6 h refresh) | F1 | `F1_ENABLED 0` hides it |
| 3 | Clock face 9 Year Dots: one dot per day, elapsed in green, public holidays amber (India + Karnataka in `HOLIDAYS`), next holiday line | CLOCK | rotate faces, web select |
| 4 | Landmarks on the dial at 60 km or less (`LANDMARKS`: Hebbal, Whitefield, E-City, Devanahalli, Yelahanka, MG Road, Nandi Hills, Hoskote) | RADAR | edit the table |
| 5 | TAF line (next change and conditions for the home airport) and SIGMET alert + line for the Chennai/Mumbai/Delhi/Kolkata FIR | RADAR legend, APPROACH | automatic, 1 h |
| 6 | Destination weather on the selected departure's card (Open-Meteo at the route destination) | RADAR card | automatic |
| 7 | Pollutants page: O3, NO2, SO2, CO with PM2.5/PM10 | WEATHER page 3 | rotate pages |
| 8 | Monsoon totals: rain this month and last 7 days from Open-Meteo daily history | WEATHER | automatic |
| 9 | Fear & greed index on the BTC page (alternative.me) | MARKETS | automatic |
| 10 | Heat map page: 12 NSE names (`HEAT_SYMBOLS`) as coloured tiles by day change | MARKETS | rotate to the page |
| 11 | Meeting timer preset: minutes only, no session counting, "TIME'S UP" alert with its own melody | POMODORO | pick `timer`, click, rotate minutes (fast turns step x4), click to start; web `Meeting timer minutes` |
| 12 | Task label shown during focus ("write the spec") | POMODORO, OLED | web `Task label` |
| 13 | Box breathing (4-4-4-4) during a break: expanding ring with breathe in / hold / out | POMODORO | click during a break, click again to stop |
| 14 | Colour themes green / amber / ice / white (rings, sweep, en-route colours, menu) | DISPLAY app (was BRIGHTNESS), web | click to the THEME row, rotate; web `Theme` |
| 15 | Quiet hours: buzzer muted between two hours, alerts still shown; alarm and emergency squawk still sound | all alerts | web `Quiet hours` (22 to 07 default, same hour = off) |
| 16 | Per-alert switches: every alert kind (traffic, heavy, watch, overhead, rain, sun, market, quake, nudge, pomodoro, break, go-around, chime, timer) can be turned off | all alerts | web checkboxes |
| 17 | Hourly chime (two notes on the hour, respects quiet hours and sleep) | buzzer | web `Hourly chime` |
| 18 | Idle behaviour: after N minutes without knob input either cycle clock, weather, stats, radar (20 s each) or return to the radar; any knob input ends it and that input is not applied to the app | all | web `Idle minutes` + mode, 0 = off |
| 19 | Health page: 24 h heap and fps history (30 min samples), last reset reason (power on, software, panic, watchdog, brownout), outages, roams | SYSTEM page 3 | rotate pages |
| 20 | WiFi roaming log: Deco node changes with time, shown on NETWORK and counted on the health page; `roamed to node xx:xx:xx` in /log | NETWORK, SYSTEM | automatic |
| 21 | Knob acceleration: fast turns or several detents per loop step x4 (brightness, custom minutes, timer minutes, replay scrub) | DISPLAY, POMODORO, REPLAY | automatic |
| 22 | Fade-in when switching apps or clock faces (palette ramp over ~150 ms, no extra RAM) | all | automatic |
| 23 | /live: both screens as images refreshed every 2 s | web | http://deskradar.local/live |
| 24 | /config.json: every setting as a downloadable JSON | web | link on the main page |
| 25 | /import: paste a config JSON (from another board or a backup); keys not present stay unchanged | web | link on the main page |

Also: the Pomodoro select list shows the timer preset in minutes, the OLED hints fit in 21 characters, APP names on the OLED menu updated (REPLAY, F1, DISPLAY), `/set` and `/import` share one `applySetting()` so both accept the same keys, airplanes.live can be kept as the preferred source across reboots (it just backs off on 403 and the chain moves on).

### Sources used in v5.2

| Data | Endpoint | Key | Interval |
|---|---|---|---|
| TAF | aviationweather.gov/api/data/taf | no | 1 h |
| SIGMET | aviationweather.gov/api/data/isigmet | no | 1 h |
| Destination weather | api.open-meteo.com forecast at the route destination | no | when the selected departure changes |
| Pollutants, rain history | air-quality-api.open-meteo.com, forecast daily with past_days | no | pollutants with weather, rain totals 6 h |
| F1 | api.jolpi.ca/ergast/f1/current/next, .../last/results | no | 6 h |
| Fear & greed | api.alternative.me/fng | no | 6 h |
| Heat map | Yahoo chart endpoint, one symbol per pass | no | while MARKETS is open |

### Checks before you trust it

| Check | Where | Expect |
|---|---|---|
| `Heap after setup: N  reset reason R` | serial / /log | N >= 70000; R = 1 (power on) or 3 (software) after an OTA |
| fps | SYSTEM page 1 or the radar bottom | 30 to 40 on RADAR |
| gateway tile | NETWORK | a number, not x (ICMP to the Deco) |
| 200s in the log | /log | adsb.lol 200 every 15 s, TAF/isigmet 200 once per hour |
| replay | REPLAY after 5 min on RADAR | tracks with a moving time bar |

Not done: Kannada/Hindi numerals (no Indic TTF in the build environment; send one and `gen_fonts.py` makes the glyphs). Melodies are a table (`MELODIES`, `MELODY_LEN` in the sketch) if you want different tunes.

### v5.2.1 additions

| Addition | Where | Control |
|---|---|---|
| Radar sweep on/off (the dial, trails and aircraft keep updating; only the sweep wedge goes) | DISPLAY app row 4, web `Sweep lines` | click to the SWEEP row, rotate toggles |
| Three independent places: radar home, arrivals board airport, weather location (`-1` = same as the radar home). Weather, AQI, pollutants, rain ring, monsoon totals, sunrise/sunset and the golden-hour/sunset alerts all follow the weather location | WEATHER page header shows the place; web `Weather location`; LOCATION app | in WEATHER hold the knob to open the picker; in LOCATION hold switches between radar home and weather location, click sets, fast turns jump 4 |
| `AIRPORTS` grown to 66: 40 India + DXB, AUH, DOH, SIN, HKG, NRT, HND, SYD, LHR, LGW, MAN, CDG, FRA, AMS, JFK, EWR, BOS, IAD, ATL, MIA, ORD, DFW, SEA, SFO, LAX, YYZ. Runway headings are true north, so US/EU designators differ from the number by the local magnetic variation | all three pickers | |
| Open-Meteo is asked for hours in `LOCAL_TZ_IANA` (Asia/Kolkata) instead of the location's own zone, so a London or Seattle forecast lines up with the clock ring, the 12 h chart and the alerts | automatic | change `LOCAL_TZ_IANA` with `LOCAL_TZ` if you move the device |

| Weather "Home" entry: first row of the weather picker, your house (`WX_HOME_*` in `config_local.h`), coordinates editable on the web page (`Weather "Home" lat/lon`). This is the default weather location on a fresh flash; the radar stays on the airport | WEATHER, LOCATION, web | pick HOME in the picker or `Home (your house)` on the web page |

Settings keys added: `wxloc` (-2 home, -1 same as radar, else airport index), `wxlat`, `wxlon`, `sweep` (NVS, /set, /config.json, /import).

### Field debugging record (Oct 2026) and what it taught

| Symptom | Real cause | Fix |
|---|---|---|
| Every HTTPS request failed with `HTTP -1 (connection refused)` within one network round trip, DNS fine, WiFi fine, 65 to 83 KB heap free | Not enough heap for mbedTLS: it needs two 16 KB buffers plus ~10 KB context at connect time, and after the first 16 KB buffer a second contiguous 16 KB block has to exist. v4.2 ran at 92 KB idle; v5.2 features and two "fix" builds pushed idle heap to 65 KB | Idle heap back to ~95 KB: JSON documents on the heap (they are freed before any connect), 3 canvas bands of 240x80 (19 KB instead of 29 KB), 3 KB log ring, 40 aircraft. Rule: keep `Heap after setup` above 85 KB and `largest block` above 40 KB |
| Weather and markets never appeared from the first flash | Same cause: their hosts were tried after the heap had already been eaten by the first TLS sessions | Same |
| Round display dim and OLED apparently off at 22:00, back after a power cycle (until NTP sync) | Night mode (22:00 to 07:00). Adafruit `dim(true)` sets OLED contrast to 0, which looks switched off | Night: round 60%, OLED contrast capped at 60/255, never below 12. Night mode on/off/auto on the web page. Transition logged |
| Wrong turns taken on the way | DNS probe (real, but secondary), power supply, RF saturation, heap fragmentation | Logging now carries timestamps, per-request duration, error text, heap and largest block, so the next diagnosis starts from data |

Logging: every outbound request goes through `httpGet()` and logs `[HH:MM:SS] <tag> ok <ms> heap <n>` or `<tag> FAIL <code> <reason> after <ms> heap <n> block <n>`. `/log` holds the last 3 KB. `net check` lines appear after three consecutive feed failures. Serial and /log are identical.

Still parked: the NETWORK app's latency probe (`NET_PROBE_ENABLED 0`) until the feeds have run a full day; REPLAY (`REPLAY_ENABLED 0`).

## v5.3.0: readable OLED

The OLED body text moved from the 6x8 built-in font (21 characters, 5 lines) to the round display's 13 px font F_SM13R (about 18 characters, 3 lines at baselines 29/44/59). Every screen builds a list of lines (`pgAdd`, `pgAddf`, `pgWrap`) and `pgDraw()` shows 3 per page; more than 3 lines becomes pages that auto-advance every `OLED_PAGE_MS` (4.5 s) with a dot column on the right edge. Lines wider than 123 px scroll sideways once (`oledLineB`). The yellow band is unchanged (size-2 title plus two 8 px lines). The news ticker is no longer a permanent 8 px line: `pgNews(n)` adds n headlines as their own pages, word-wrapped. WEATHER keeps its 12 h bar chart as custom page 0 (`pgDraw(1)`). Default arguments for the pager functions live in the forward declarations in p1 because the Arduino prototype generator cannot carry them.

Also in 5.2.2 / 5.3.0: `heapGuardTick()` restarts the board if the largest free block stays under 40 KB for 10 minutes (TLS cannot connect below ~40 KB), and a zero-aircraft 200 response logs the query centre, radius, body length and filter.
