hariksk25/Desk-assistant-/docs/images/wiring_v6.png

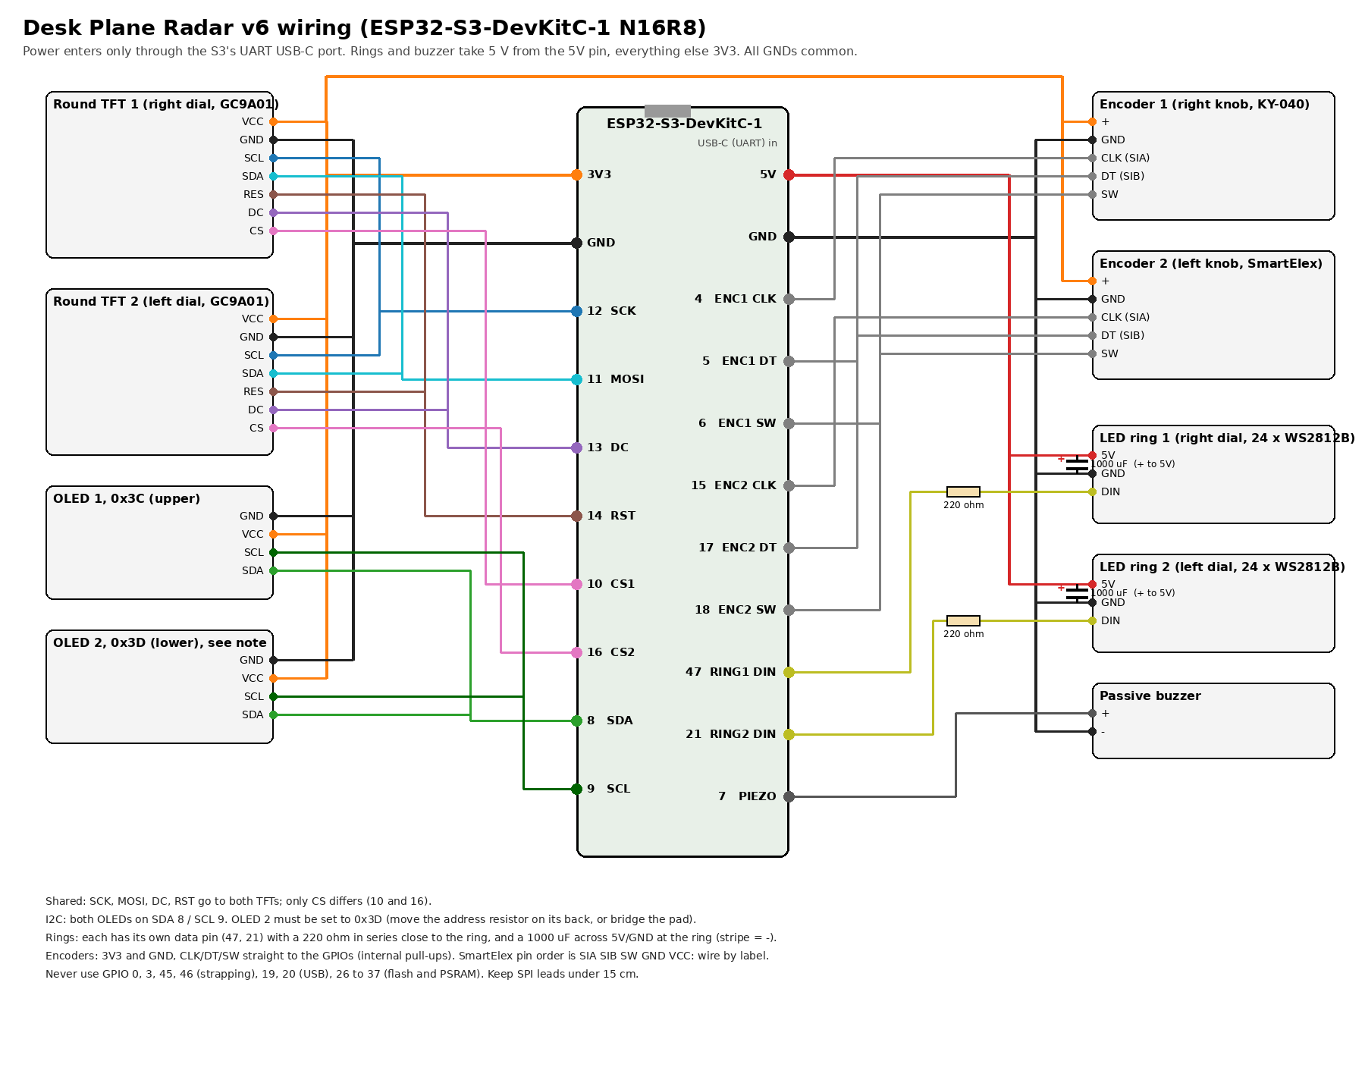
docs/images/wiring_v6.png
