hariksk25/Desk-assistant-/docs/images/wiring_v6_panel.png

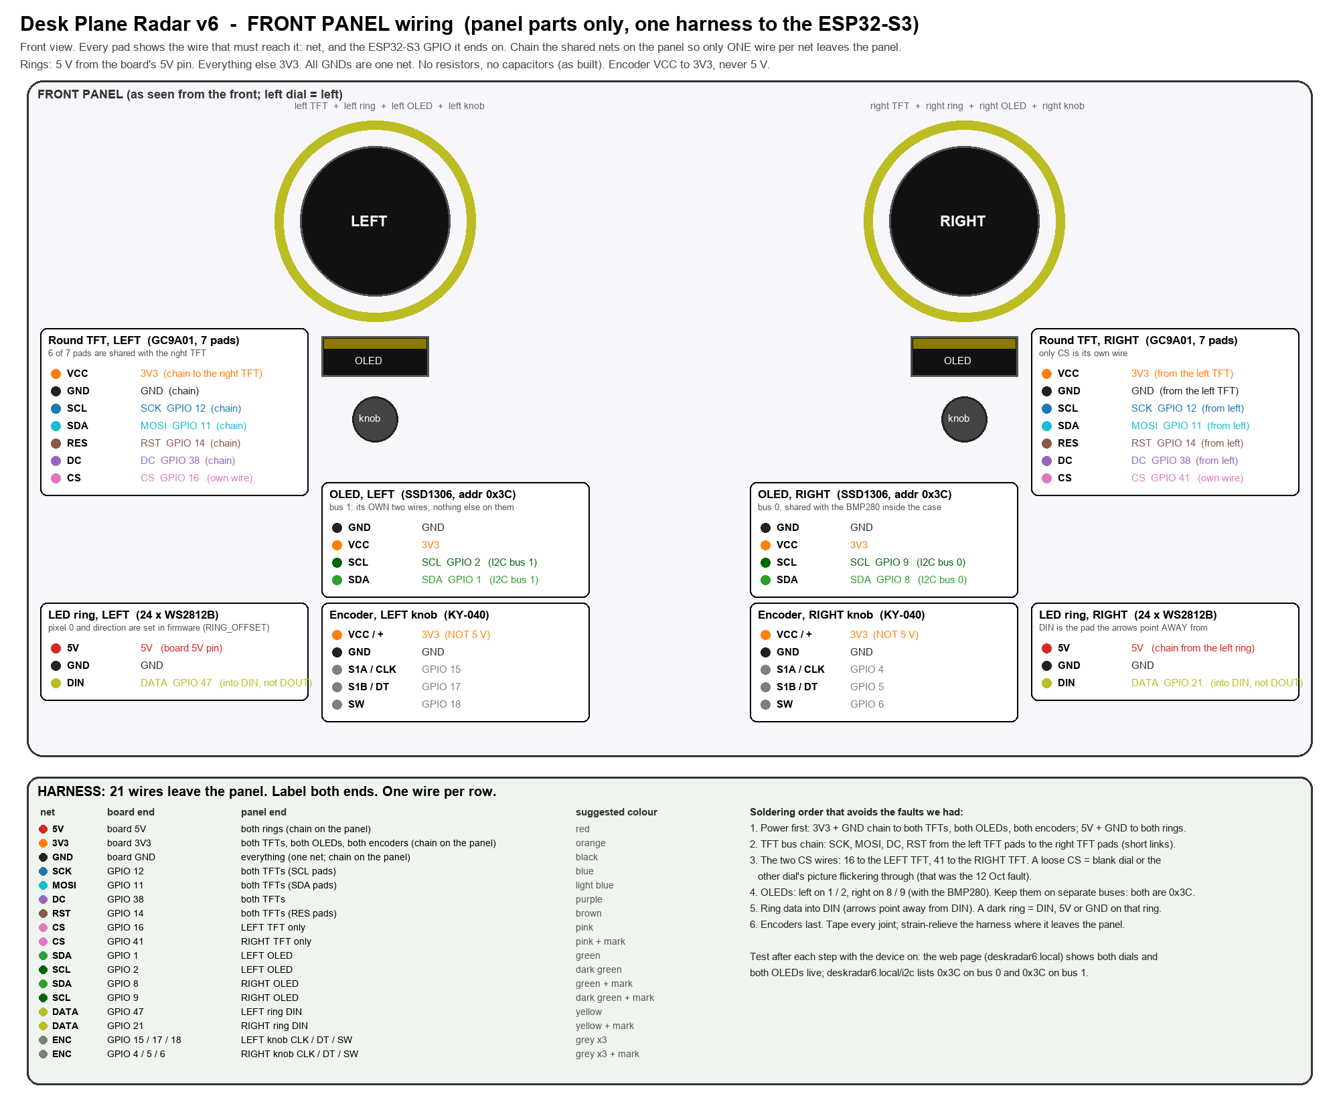
docs/images/wiring_v6_panel.png
